aditilagisetty/PIE-Mini-Project-2-3D-Scanner/PIE Mini Project 2/ca_shape_front.png

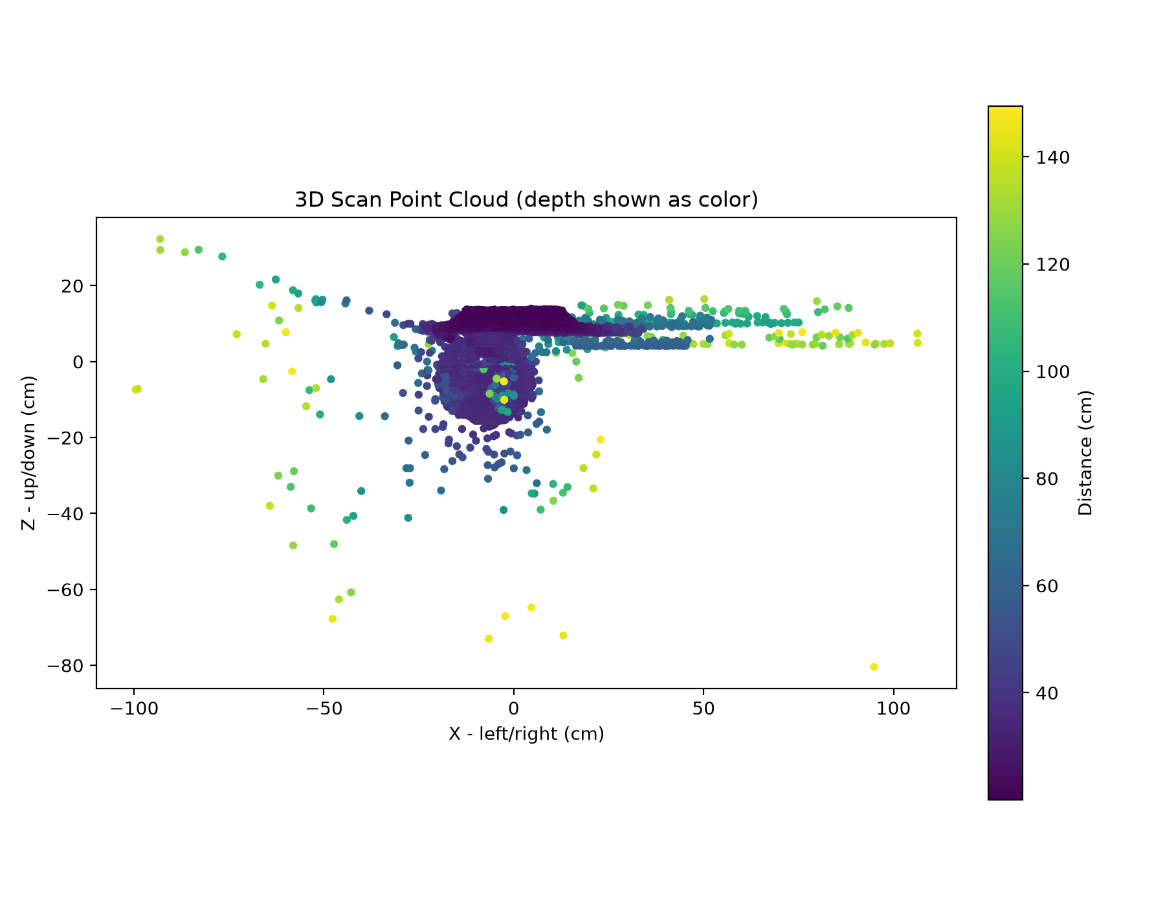
PIE Mini Project 2/ca_shape_front.png
