aditilagisetty/PIE-Mini-Project-2-3D-Scanner/PIE Mini Project 2/ca_shape_side_polar.png

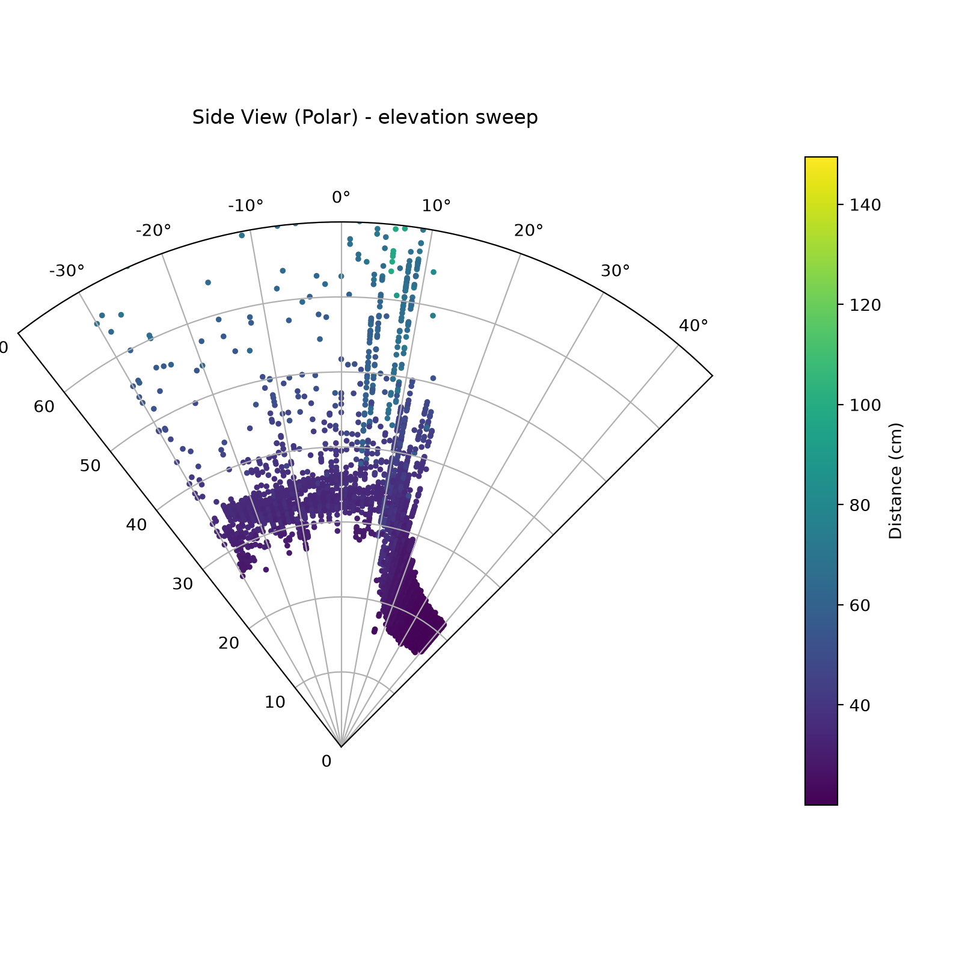
PIE Mini Project 2/ca_shape_side_polar.png
