aditilagisetty/PIE-Mini-Project-2-3D-Scanner/PIE Mini Project 2/ca_shape_topdown.png

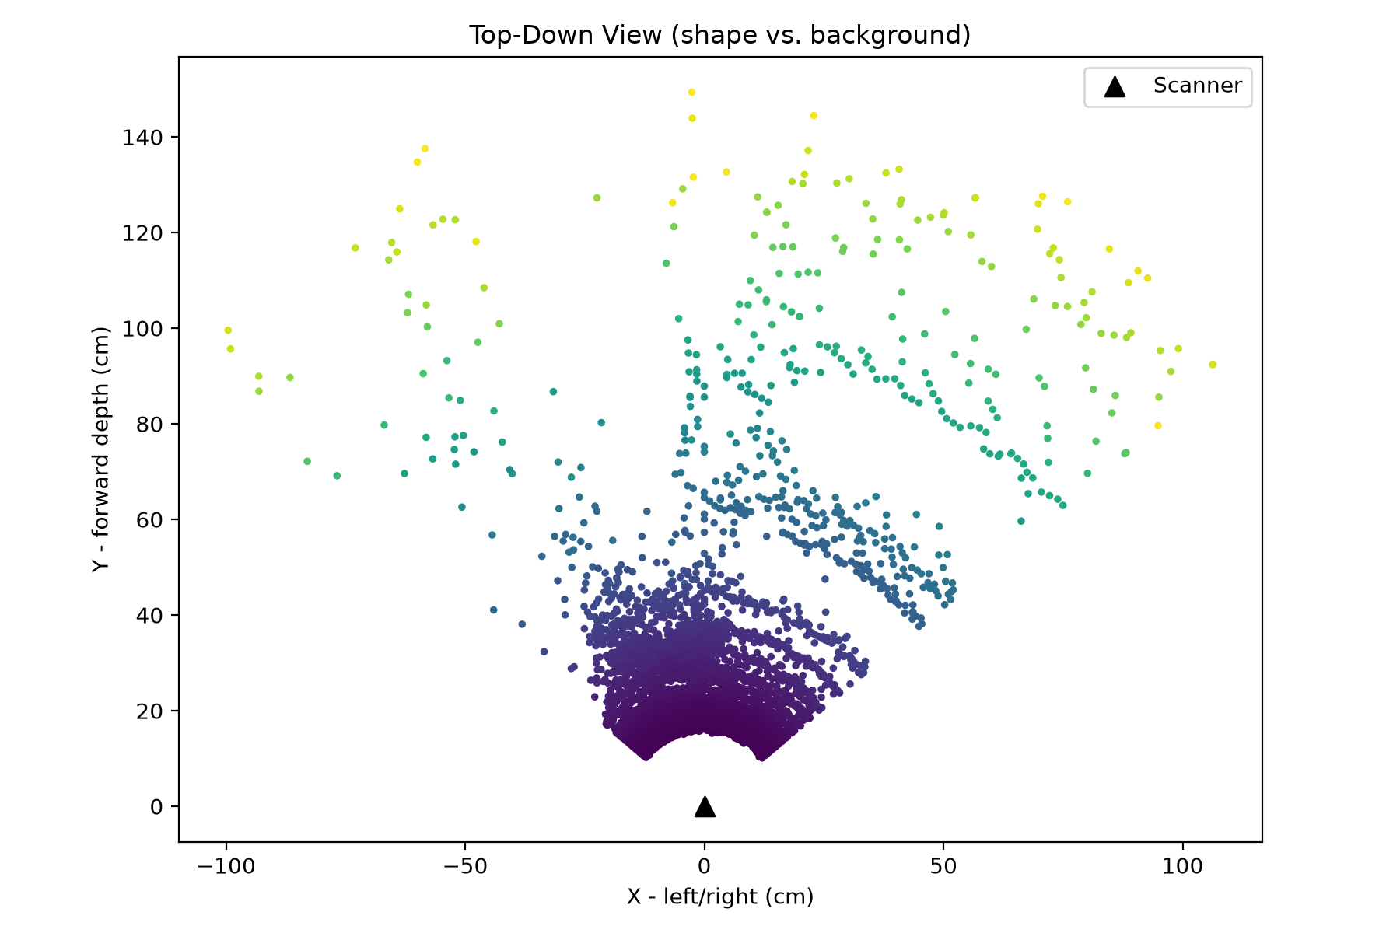
PIE Mini Project 2/ca_shape_topdown.png
