aditilagisetty/PIE-Mini-Project-2-3D-Scanner/PIE Mini Project 2/error_plot.png

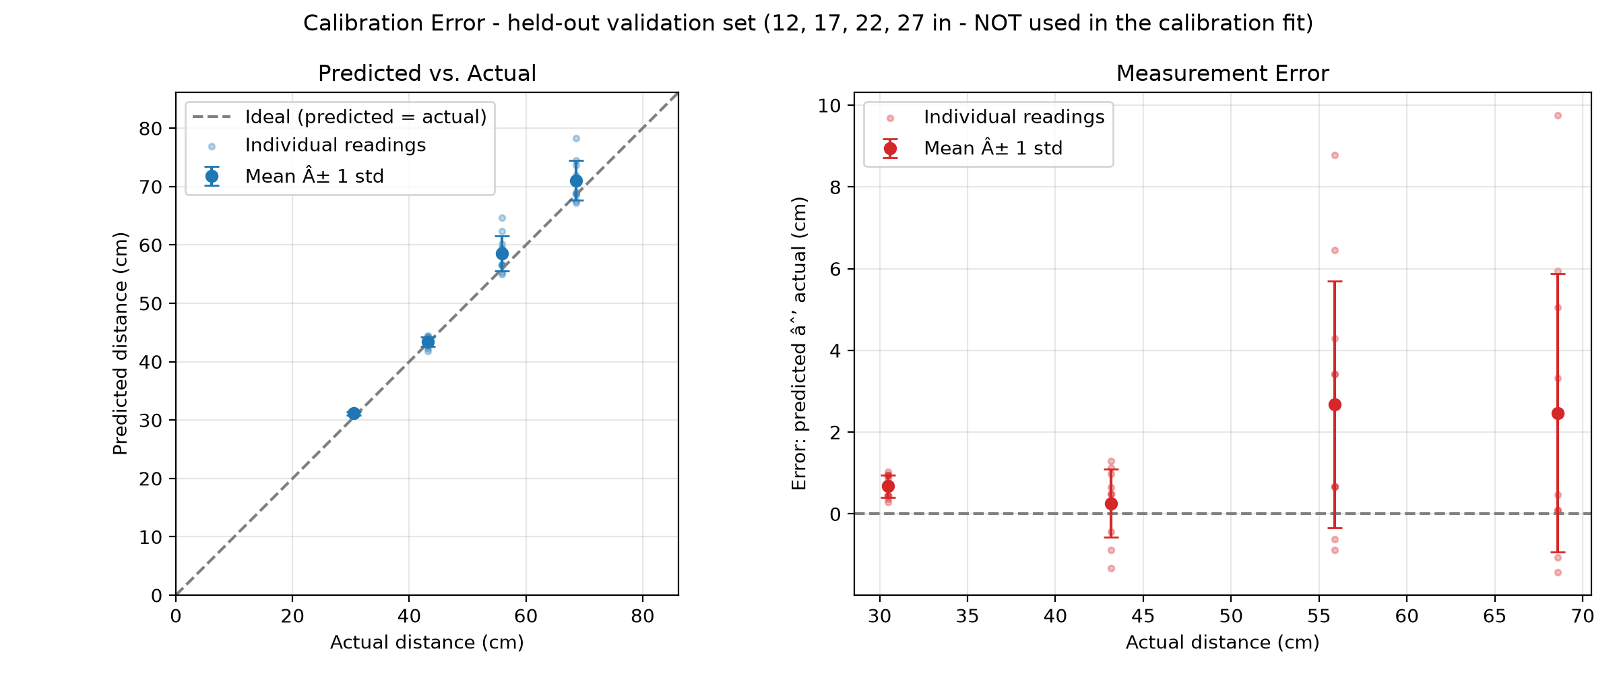
PIE Mini Project 2/error_plot.png
