aditilagisetty/PIE-Mini-Project-2-3D-Scanner/PIE Mini Project 2/scan_data_front_polar.png

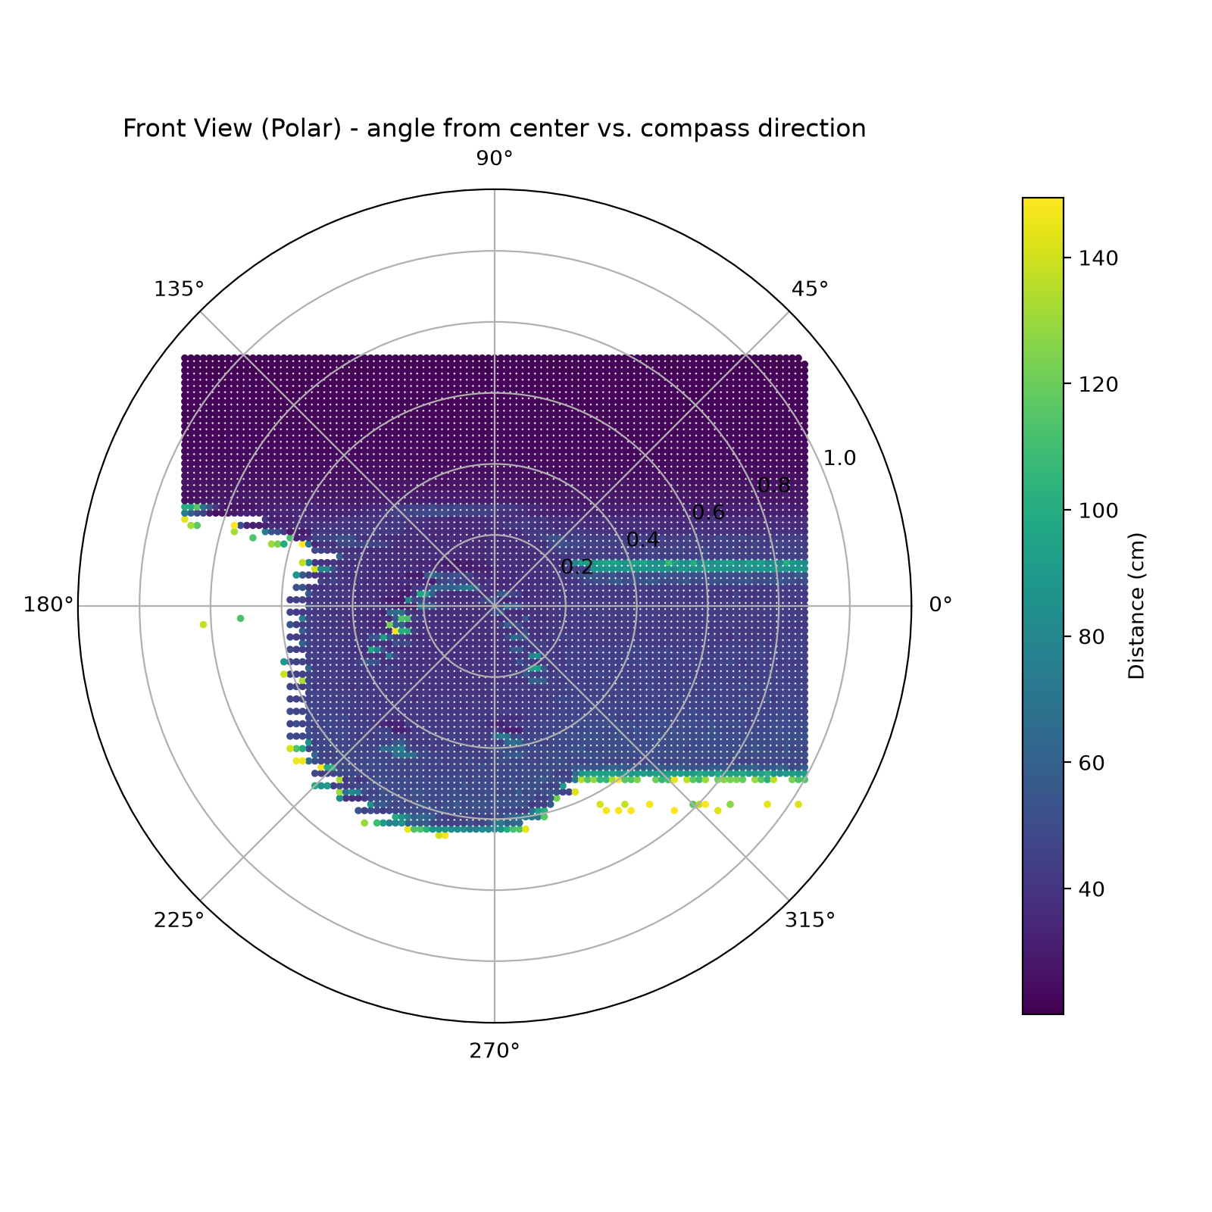
PIE Mini Project 2/scan_data_front_polar.png
