aditilagisetty/PIE-Mini-Project-2-3D-Scanner/PIE Mini Project 2/scan_data_side_polar.png

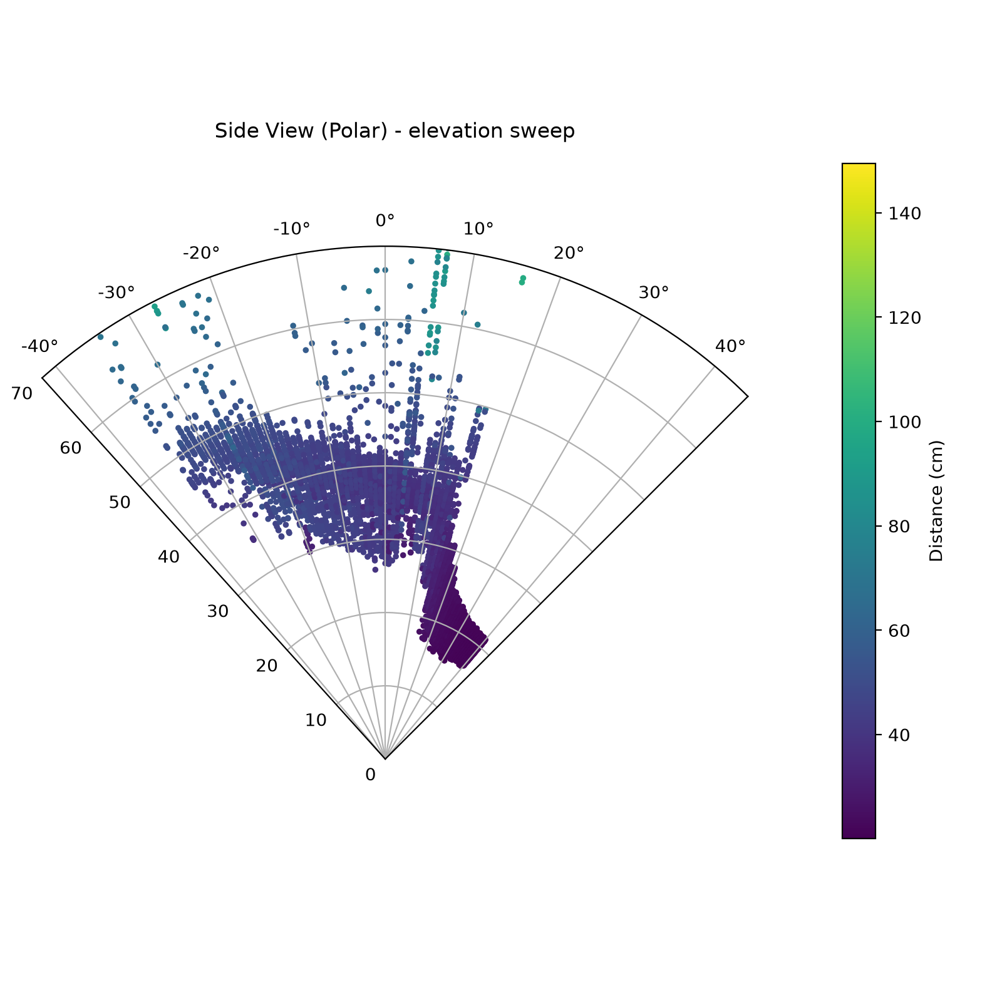
PIE Mini Project 2/scan_data_side_polar.png
