aditilagisetty/PIE-Mini-Project-2-3D-Scanner/PIE Mini Project 2/scan_data_topdown.png

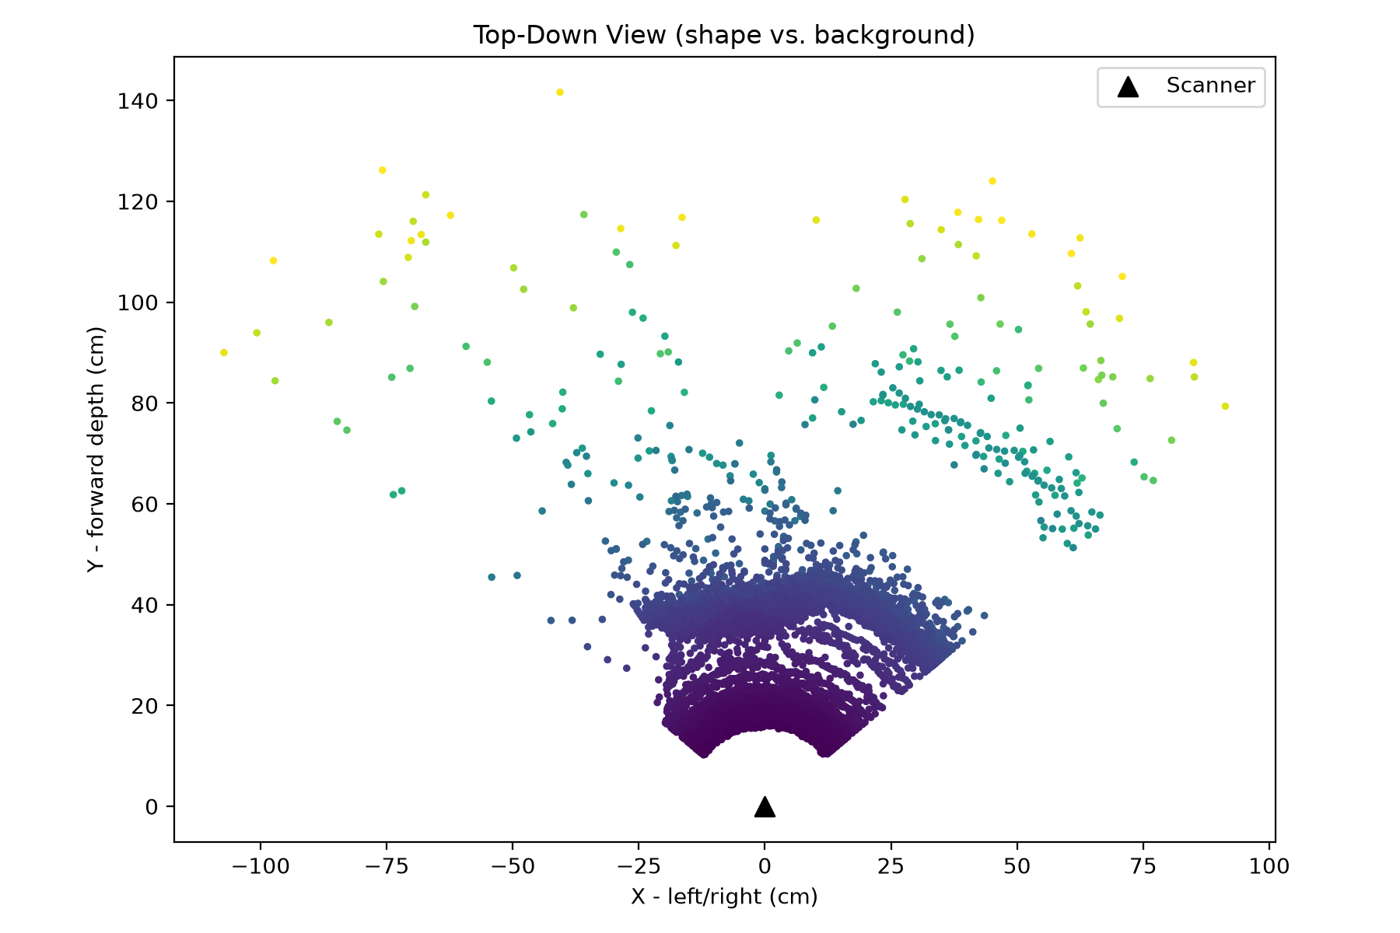
PIE Mini Project 2/scan_data_topdown.png
