aditilagisetty/PIE-Mini-Project-2-3D-Scanner/PIE Mini Project 2/top down view.png

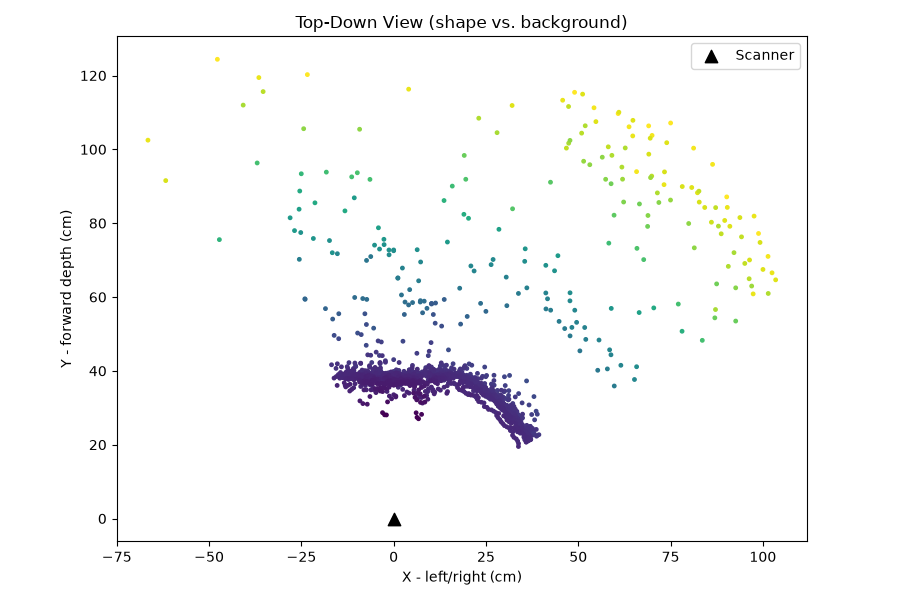
PIE Mini Project 2/top down view.png
