aditilagisetty/PIE-Mini-Project-2-3D-Scanner/PIE Mini Project 2/calibration_data.csv

distance_in | distance_cm | raw_sensor_value
5 | 12.7 | 583
5 | 12.7 | 588
5 | 12.7 | 582
5 | 12.7 | 583
5 | 12.7 | 582
5 | 12.7 | 580
5 | 12.7 | 593
5 | 12.7 | 578
5 | 12.7 | 587
5 | 12.7 | 578
10 | 25.4 | 470
10 | 25.4 | 472
10 | 25.4 | 459
10 | 25.4 | 464
10 | 25.4 | 462
10 | 25.4 | 468
10 | 25.4 | 471
10 | 25.4 | 464
10 | 25.4 | 461
10 | 25.4 | 465
15 | 38.1 | 339
15 | 38.1 | 330
15 | 38.1 | 337
15 | 38.1 | 333
15 | 38.1 | 335
15 | 38.1 | 337
15 | 38.1 | 331
15 | 38.1 | 330
15 | 38.1 | 333
15 | 38.1 | 341
20 | 50.8 | 258
20 | 50.8 | 246
20 | 50.8 | 247
20 | 50.8 | 252
20 | 50.8 | 251
20 | 50.8 | 251
20 | 50.8 | 249
20 | 50.8 | 249
20 | 50.8 | 256
20 | 50.8 | 250
25 | 63.5 | 198
25 | 63.5 | 200
25 | 63.5 | 195
25 | 63.5 | 194
25 | 63.5 | 199
25 | 63.5 | 182
25 | 63.5 | 204
25 | 63.5 | 190
25 | 63.5 | 197
25 | 63.5 | 194
30 | 76.2 | 161
30 | 76.2 | 153
30 | 76.2 | 167
30 | 76.2 | 153
30 | 76.2 | 166
30 | 76.2 | 157
30 | 76.2 | 168
30 | 76.2 | 179
30 | 76.2 | 166
30 | 76.2 | 168
