aditilagisetty/PIE-Mini-Project-2-3D-Scanner/PIE Mini Project 2/validation_data.csv

distance_in | distance_cm | raw_sensor_value
12 | 30.48 | 399
12 | 30.48 | 390
12 | 30.48 | 391
12 | 30.48 | 392
12 | 30.48 | 398
12 | 30.48 | 397
12 | 30.48 | 397
12 | 30.48 | 391
12 | 30.48 | 391
12 | 30.48 | 397
17 | 43.18 | 283
17 | 43.18 | 290
17 | 43.18 | 286
17 | 43.18 | 279
17 | 43.18 | 293
17 | 43.18 | 280
17 | 43.18 | 296
17 | 43.18 | 281
17 | 43.18 | 284
17 | 43.18 | 284
22 | 55.88 | 201
22 | 55.88 | 221
22 | 55.88 | 211
22 | 55.88 | 226
22 | 55.88 | 221
22 | 55.88 | 211
22 | 55.88 | 221
22 | 55.88 | 194
22 | 55.88 | 227
22 | 55.88 | 208
27 | 68.58 | 182
27 | 68.58 | 175
27 | 68.58 | 187
27 | 68.58 | 169
27 | 68.58 | 183
27 | 68.58 | 177
27 | 68.58 | 171
27 | 68.58 | 186
27 | 68.58 | 161
27 | 68.58 | 183
