aditilagisetty/PIE-Mini-Project-2-3D-Scanner/PIE Mini Project 2/debug_near_shape.png

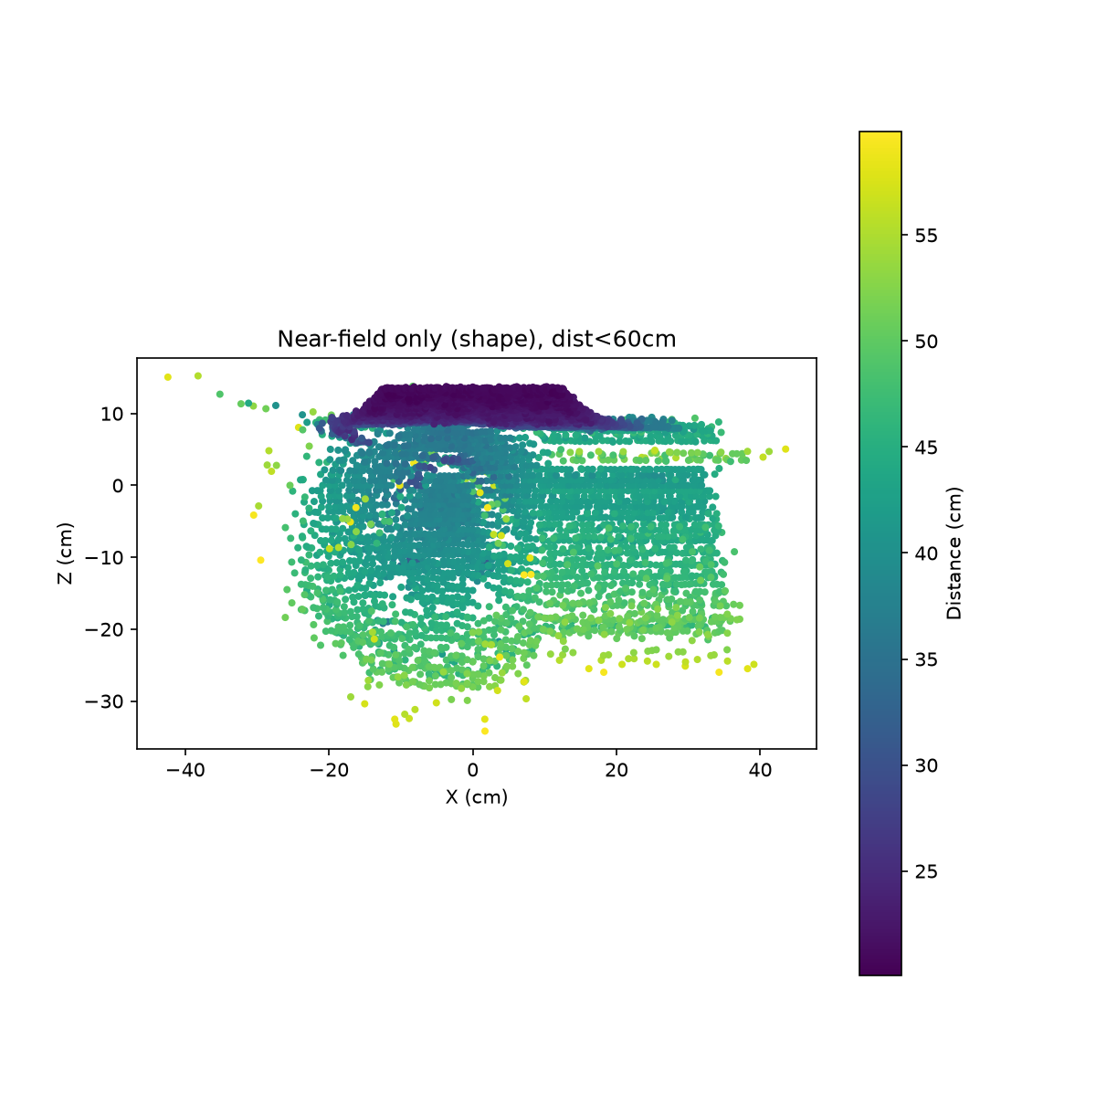
PIE Mini Project 2/debug_near_shape.png
